AntoonGa/Network_Analyser_Arduino/MCP3002_SPI/main/Tutorial/schematic.png

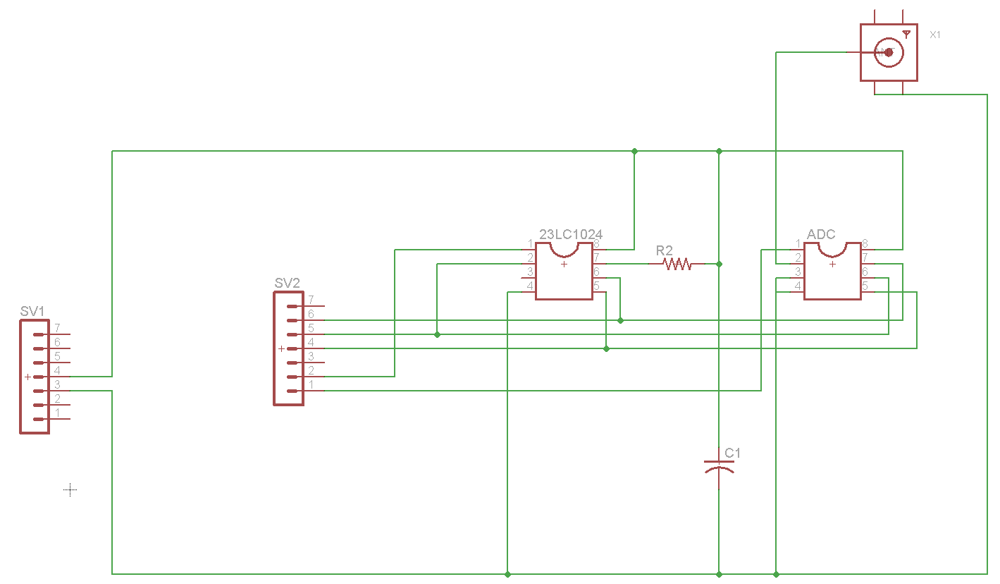
MCP3002_SPI/main/Tutorial/schematic.png
